Brendanofawesome/SimpleFOC-DualESC/KiCad/simpleFOC Dual Motor Controller.kicad_pcb

## KiCad design KiCad/simpleFOC Dual Motor Controller.kicad_pcb (2026-11-06)

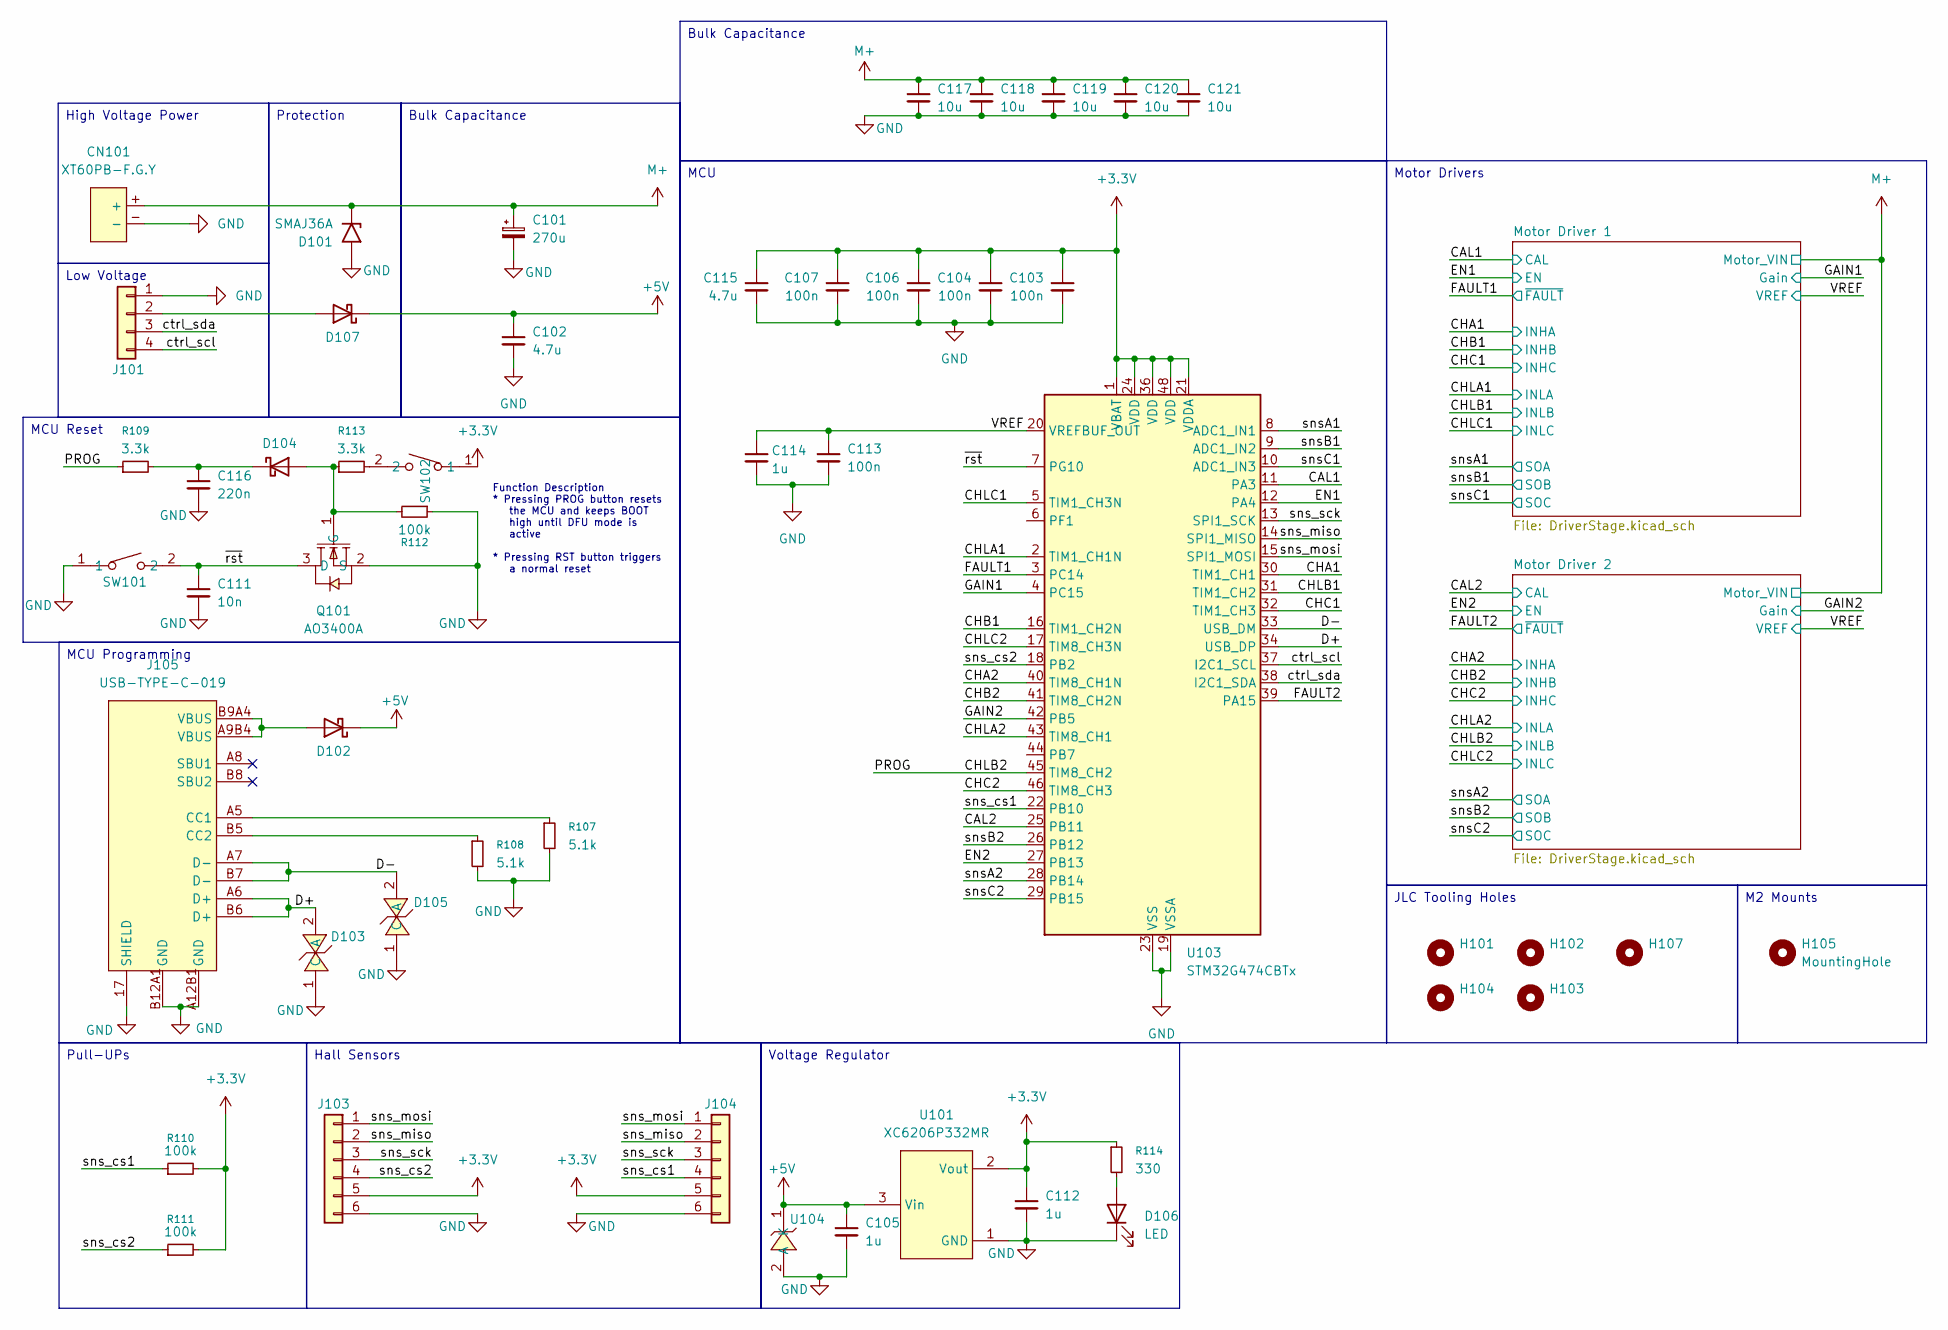
[picture p1: schematic simpleFOC Dual Motor Controller.kicad_sch]

Parts:
C101: 270u; CAP-TH_BD8.0-P3.50-D0.6-FD; LCSC C55079818
C102, C115: 4.7u; C_0402_1005Metric; LCSC C23733
C103, C104, C106, C107, C113: 100n; C_0402_1005Metric; LCSC C307331
C105, C112, C114: 1u; C_0402_1005Metric; LCSC C52923
C111: 10n; C_0402_1005Metric; LCSC C15195
C116: 220n; C_0402_1005Metric; LCSC C16772
C117, C118, C119, C120, C121: 10u; C_1206_3216Metric; LCSC C13585
CN101: XT60PB-F.G.Y; CONN-TH_XT60PB-F.G.Y; MPN XT60PB-F.G.Y; LCSC Part C19268038
D101: SMAJ36A; D_SMA; LCSC C19077550
D102, D104, D107: 1N5819WS; D_SOD-323; LCSC C191023
D103, D105: H5VL10B; SOD-882_L1.0-W0.6-BI; MPN H5VL10B; LCSC Part C7420372
D106: LED; LED_0603_1608Metric; LCSC C2290
H101, H102, H103, H104, H107: MountingHole; JLC_Tooling_Hole
H105: MountingHole; MountingHole_2.2mm_M2
J101: Conn_01x04; JST_PH_B4B-PH-K_1x04_P2.00mm_Vertical; LCSC C131334
J103, J104: Conn_01x06; JST_PH_B6B-PH-K_1x06_P2.00mm_Vertical; LCSC C131342
J105: USB-TYPE-C-019; TYPE-C-SMD_HX-TYPE-C-16PIN; MPN USB-TYPE-C-019; LCSC Part C2927039
Q101: AO3400A; SOT-23-3_L2.9-W1.3-P1.90-LS2.4-BR; MPN AO3400A; LCSC Part C20917
R107, R108: 5.1k; R_0402_1005Metric; LCSC C25905
R109, R113: 3.3k; R_0402_1005Metric; LCSC C25890
R110, R111, R112: 100k; R_0402_1005Metric; LCSC C25741
R114: 330; R_0402_1005Metric; LCSC C25104
SW101, SW102: TS-1088-AR02016; SW-SMD_L3.9-W3.0-P4.45; MPN TS-1088-AR02016; LCSC Part C720477
U101: XC6206P332MR; SOT-23-3_L2.9-W1.6-P1.90-LS2.8-BR; MPN XC6206P332MR-G; LCSC Part C5446
U103: STM32G474CBTx; LQFP-48_7x7mm_P0.5mm; LCSC C730123
U104: H5VND5UB; SOD-523F_L1.7-W0.9-LS1.7-RD; MPN H5VND5UB; LCSC Part C20615819

Connections:
+3.3V: C103.1, C104.1, C106.1, C107.1, C112.1, C115.1, J103.5, J104.5, R110.2, R111.2, R114.1, SW102.1, U101.2 (Vout), U103.1 (VBAT), U103.21 (VDDA), U103.24 (VDD), U103.36 (VDD), U103.48 (VDD); also elsewhere on the board
+5V: C102.1, C105.1, D102.1 (K), D107.1 (K), U101.3 (Vin), U104.1 (K)
/CAL1: U103.11 (PA3); also elsewhere on the board
/CAL2: U103.25 (PB11); also elsewhere on the board
/CHA1: U103.30 (TIM1_CH1); also elsewhere on the board
/CHA2: U103.40 (TIM8_CH1N); also elsewhere on the board
/CHB1: U103.16 (TIM1_CH2N); also elsewhere on the board
/CHB2: U103.41 (TIM8_CH2N); also elsewhere on the board
/CHC1: U103.32 (TIM1_CH3); also elsewhere on the board
/CHC2: U103.46 (TIM8_CH3); also elsewhere on the board
/CHLA1: U103.2 (TIM1_CH1N); also elsewhere on the board
/CHLA2: U103.43 (TIM8_CH1); also elsewhere on the board
/CHLB1: U103.31 (TIM1_CH2); also elsewhere on the board
/CHLB2: R109.1, U103.45 (TIM8_CH2); also elsewhere on the board
/CHLC1: U103.5 (TIM1_CH3N); also elsewhere on the board
/CHLC2: U103.17 (TIM8_CH3N); also elsewhere on the board
/D+: D103.2 (A), J105.A6 (D+), J105.B6 (D+), U103.34 (USB_DP)
/D-: D105.2 (A), J105.A7 (D-), J105.B7 (D-), U103.33 (USB_DM)
/EN1: U103.12 (PA4); also elsewhere on the board
/EN2: U103.27 (PB13); also elsewhere on the board
/FAULT1: U103.3 (PC14); also elsewhere on the board
/FAULT2: U103.39 (PA15); also elsewhere on the board
/GAIN1: U103.4 (PC15); also elsewhere on the board
/GAIN2: U103.42 (PB5); also elsewhere on the board
/VREF: C113.1, C114.1, U103.20 (VREFBUF_OUT); also elsewhere on the board
/ctrl_scl: J101.4, U103.37 (I2C1_SCL)
/ctrl_sda: J101.3, U103.38 (I2C1_SDA)
/snsA1: U103.8 (ADC1_IN1); also elsewhere on the board
/snsA2: U103.28 (PB14); also elsewhere on the board
/snsB1: U103.9 (ADC1_IN2); also elsewhere on the board
/snsB2: U103.26 (PB12); also elsewhere on the board
/snsC1: U103.10 (ADC1_IN3); also elsewhere on the board
/snsC2: U103.29 (PB15); also elsewhere on the board
/sns_cs1: J104.4, R110.1, U103.22 (PB10)
/sns_cs2: J103.4, R111.1, U103.18 (PB2)
/sns_miso: J103.2, J104.2, U103.14 (SPI1_MISO)
/sns_mosi: J103.1, J104.1, U103.15 (SPI1_MOSI)
/sns_sck: J103.3, J104.3, U103.13 (SPI1_SCK)
/~rst: C111.1, Q101.3 (D), SW101.2, U103.7 (PG10)
GND: C101.2, C102.2, C103.2, C104.2, C105.2, C106.2, C107.2, C111.2, C112.2, C113.2, C114.2, C115.2, C116.2, C117.2, C118.2, C119.2, C120.2, C121.2, CN101.-, D101.2 (A2), D103.1 (C), D105.1 (C), D106.1 (K), J101.1, J103.6, J104.6, J105.17 (SHIELD), J105.A12B1 (GND), J105.B12A1 (GND), Q101.2 (S), R107.2, R108.2, R112.1, SW101.1, U101.1 (GND), U103.19 (VSSA), U103.23 (VSS), U103.35 (VSS), U103.47 (VSS), U104.2 (A); also elsewhere on the board
M+: C101.1, C117.1, C118.1, C119.1, C120.1, C121.1, CN101.+, D101.1 (A1); also elsewhere on the board
unnamed: D102.2 (A), J105.A9B4 (VBUS), J105.B9A4 (VBUS)
unnamed: D104.2 (A), Q101.1 (G), R112.2, R113.1
unnamed: C116.1, D104.1 (K), R109.2
unnamed: D106.2 (A), R114.2
unnamed: D107.2 (A), J101.2
unnamed: J105.A5 (CC1), R107.1
unnamed: J105.B5 (CC2), R108.1
unnamed: R113.2, SW102.2

Notes on the sheet:
Function Description * Pressing PROG button resets the MCU and keeps BOOT high until DFU mode is active * Pressing RST button triggers a normal reset
MCU
MCU Reset
Bulk Capacitance
Pull-UPs
JLC Tooling Holes
High Voltage Power
Hall Sensors
Protection
Motor Drivers
Low Voltage
Voltage Regulator
M2 Mounts
MCU Programming

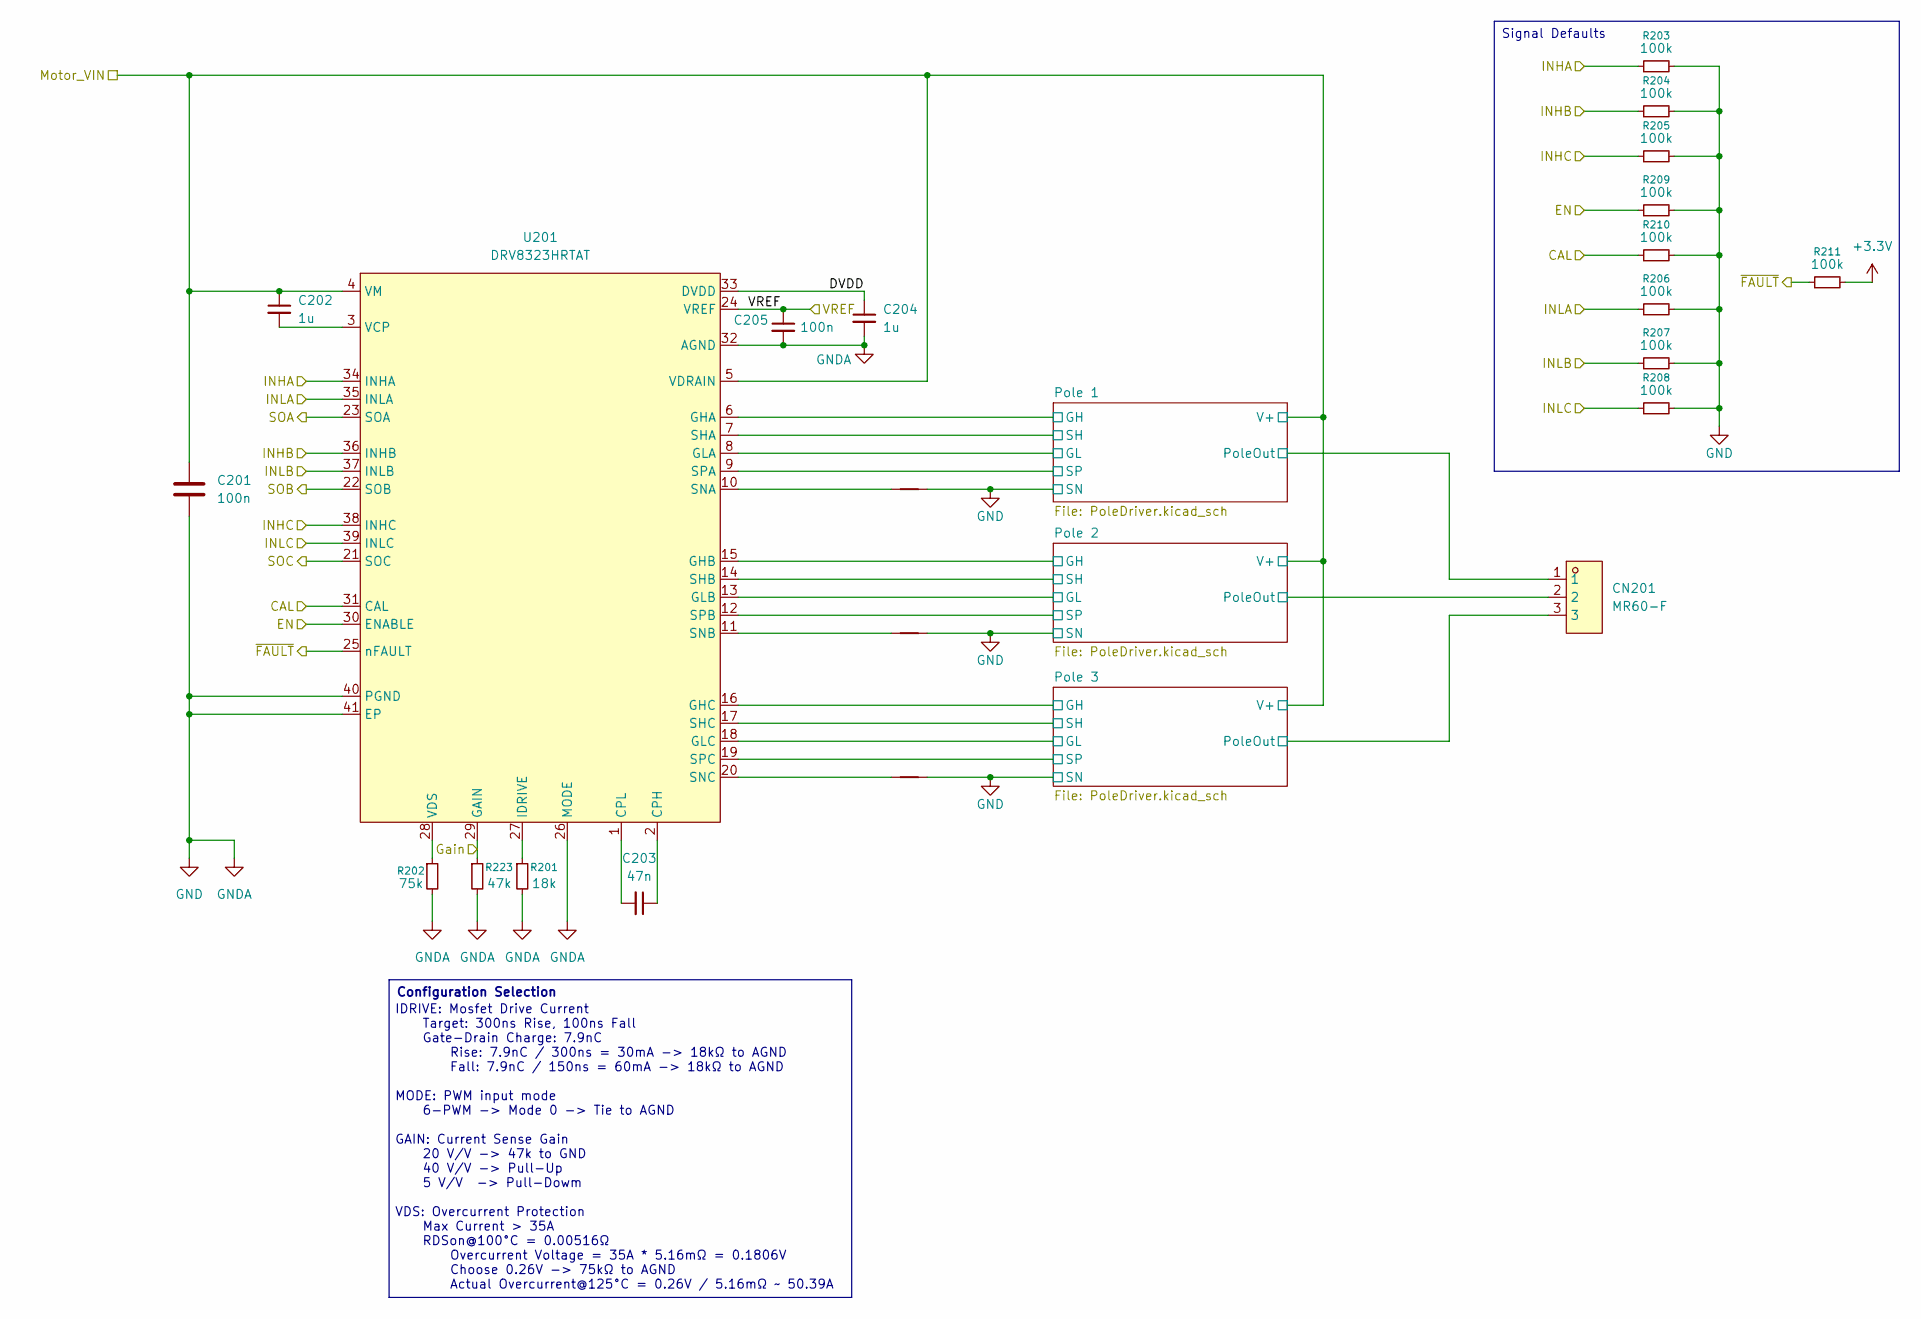
[picture p2: schematic DriverStage.kicad_sch]

Parts:
C201, C205: 100n; C_0402_1005Metric; LCSC C307331
C202: 1u; C_0603_1608Metric; LCSC C15849
C203: 47n; C_0603_1608Metric; LCSC C1622
C204: 1u; C_0402_1005Metric; LCSC C52923
CN201: MR60-F; CONN-TH_3P-P5.50_MR60-F; MPN MR60-F; LCSC Part C9900023305
NT201, NT202, NT203: NetTie_2; NetTie0.127mm
R201: 18k; R_0402_1005Metric; LCSC C25762
R202: 75k; R_0402_1005Metric; LCSC C25798
R203, R204, R205, R206, R207, R208, R209, R210, R211: 100k; R_0402_1005Metric; LCSC C25741
R223: 47k; R_0402_1005Metric; LCSC C25792
U201: DRV8323HRTAT; WQFN-40_L6.0-W6.0-P0.50-TL-EP4.2; MPN DRV8323HRTAT; LCSC Part C2150673

Connections:
+3.3V: R211.2; also elsewhere on the board
/CAL1: R210.1, U201.31 (CAL); also elsewhere on the board
/CHA1: R203.1, U201.34 (INHA); also elsewhere on the board
/CHB1: R204.1, U201.36 (INHB); also elsewhere on the board
/CHC1: R205.1, U201.38 (INHC); also elsewhere on the board
/CHLA1: R206.1, U201.35 (INLA); also elsewhere on the board
/CHLB1: R207.1, U201.37 (INLB); also elsewhere on the board
/CHLC1: R208.1, U201.39 (INLC); also elsewhere on the board
/EN1: R209.1, U201.30 (ENABLE); also elsewhere on the board
/FAULT1: R211.1, U201.25 (nFAULT); also elsewhere on the board
/GAIN1: R223.1, U201.29 (GAIN); also elsewhere on the board
/Motor Driver 1/DVDD: C204.1, U201.33 (DVDD)
/Motor Driver 1/Pole 1/GH: U201.6 (GHA); also elsewhere on the board
/Motor Driver 1/Pole 1/GL: U201.8 (GLA); also elsewhere on the board
/Motor Driver 1/Pole 1/PoleOut: CN201.1, U201.7 (SHA); also elsewhere on the board
/Motor Driver 1/Pole 1/SP: U201.9 (SPA); also elsewhere on the board
/Motor Driver 1/Pole 2/GH: U201.15 (GHB); also elsewhere on the board
/Motor Driver 1/Pole 2/GL: U201.13 (GLB); also elsewhere on the board
/Motor Driver 1/Pole 2/PoleOut: CN201.2, U201.14 (SHB); also elsewhere on the board
/Motor Driver 1/Pole 2/SP: U201.12 (SPB); also elsewhere on the board
/Motor Driver 1/Pole 3/GH: U201.16 (GHC); also elsewhere on the board
/Motor Driver 1/Pole 3/GL: U201.18 (GLC); also elsewhere on the board
/Motor Driver 1/Pole 3/PoleOut: CN201.3, U201.17 (SHC); also elsewhere on the board
/Motor Driver 1/Pole 3/SP: U201.19 (SPC); also elsewhere on the board
/VREF: C205.1, U201.24 (VREF); also elsewhere on the board
/snsA1: U201.23 (SOA); also elsewhere on the board
/snsB1: U201.22 (SOB); also elsewhere on the board
/snsC1: U201.21 (SOC); also elsewhere on the board
GND: C201.2, C204.2, C205.2, NT201.2, NT202.2, NT203.2, R201.2, R202.2, R203.2, R204.2, R205.2, R206.2, R207.2, R208.2, R209.2, R210.2, R223.2, U201.26 (MODE), U201.32 (AGND), U201.40 (PGND), U201.41 (EP); also elsewhere on the board
M+: C201.1, C202.1, U201.4 (VM), U201.5 (VDRAIN); also elsewhere on the board
unnamed: C203.1, U201.2 (CPH)
unnamed: C203.2, U201.1 (CPL)
unnamed: R201.1, U201.27 (IDRIVE)
unnamed: NT201.1, U201.10 (SNA)
unnamed: NT202.1, U201.11 (SNB)
unnamed: NT203.1, U201.20 (SNC)
unnamed: C202.2, U201.3 (VCP)
unnamed: R202.1, U201.28 (VDS)

Parts of its further copies:
C206, C209: 100n; C_0402_1005Metric; LCSC C307331
C207: 1u; C_0603_1608Metric; LCSC C15849
C208: 47n; C_0603_1608Metric; LCSC C1622
C210: 1u; C_0402_1005Metric; LCSC C52923
CN202: MR60-F; CONN-TH_3P-P5.50_MR60-F; MPN MR60-F; LCSC Part C9900023305
NT204, NT205, NT206: NetTie_2; NetTie0.127mm
R212: 75k; R_0402_1005Metric; LCSC C25798
R213: 18k; R_0402_1005Metric; LCSC C25762
R214, R215, R216, R220, R221, R222, R602, R603, R604: 100k; R_0402_1005Metric; LCSC C25741
R601: 47k; R_0402_1005Metric; LCSC C25792
U202: DRV8323HRTAT; WQFN-40_L6.0-W6.0-P0.50-TL-EP4.2; MPN DRV8323HRTAT; LCSC Part C2150673

Connections of its further copies:
+3.3V: R222.2; also elsewhere on the board
/CAL2: R221.1, U202.31 (CAL); also elsewhere on the board
/CHA2: R214.1, U202.34 (INHA); also elsewhere on the board
/CHB2: R215.1, U202.36 (INHB); also elsewhere on the board
/CHC2: R216.1, U202.38 (INHC); also elsewhere on the board
/CHLA2: R602.1, U202.35 (INLA); also elsewhere on the board
/CHLB2: R603.1, U202.37 (INLB); also elsewhere on the board
/CHLC2: R604.1, U202.39 (INLC); also elsewhere on the board
/EN2: R220.1, U202.30 (ENABLE); also elsewhere on the board
/FAULT2: R222.1, U202.25 (nFAULT); also elsewhere on the board
/GAIN2: R601.1, U202.29 (GAIN); also elsewhere on the board
/Motor Driver 2/DVDD: C210.1, U202.33 (DVDD)
/Motor Driver 2/Pole 1/GH: U202.6 (GHA); also elsewhere on the board
/Motor Driver 2/Pole 1/GL: U202.8 (GLA); also elsewhere on the board
/Motor Driver 2/Pole 1/PoleOut: CN202.1, U202.7 (SHA); also elsewhere on the board
/Motor Driver 2/Pole 1/SP: U202.9 (SPA); also elsewhere on the board
/Motor Driver 2/Pole 2/GH: U202.15 (GHB); also elsewhere on the board
/Motor Driver 2/Pole 2/GL: U202.13 (GLB); also elsewhere on the board
/Motor Driver 2/Pole 2/PoleOut: CN202.2, U202.14 (SHB); also elsewhere on the board
/Motor Driver 2/Pole 2/SP: U202.12 (SPB); also elsewhere on the board
/Motor Driver 2/Pole 3/GH: U202.16 (GHC); also elsewhere on the board
/Motor Driver 2/Pole 3/GL: U202.18 (GLC); also elsewhere on the board
/Motor Driver 2/Pole 3/PoleOut: CN202.3, U202.17 (SHC); also elsewhere on the board
/Motor Driver 2/Pole 3/SP: U202.19 (SPC); also elsewhere on the board
/VREF: C209.1, U202.24 (VREF); also elsewhere on the board
/snsA2: U202.23 (SOA); also elsewhere on the board
/snsB2: U202.22 (SOB); also elsewhere on the board
/snsC2: U202.21 (SOC); also elsewhere on the board
GND: C206.2, C209.2, C210.2, NT204.2, NT205.2, NT206.2, R212.2, R213.2, R214.2, R215.2, R216.2, R220.2, R221.2, R601.2, R602.2, R603.2, R604.2, U202.26 (MODE), U202.32 (AGND), U202.40 (PGND), U202.41 (EP); also elsewhere on the board
M+: C206.1, C207.1, U202.4 (VM), U202.5 (VDRAIN); also elsewhere on the board
unnamed: C208.1, U202.2 (CPH)
unnamed: C208.2, U202.1 (CPL)
unnamed: R213.1, U202.27 (IDRIVE)
unnamed: NT204.1, U202.10 (SNA)
unnamed: NT205.1, U202.11 (SNB)
unnamed: NT206.1, U202.20 (SNC)
unnamed: C207.2, U202.3 (VCP)
unnamed: R212.1, U202.28 (VDS)

Notes on the sheet:
IDRIVE: Mosfet Drive Current Target: 300ns Rise, 100ns Fall Gate-Drain Charge: 7.9nC Rise: 7.9nC / 300ns = 30mA -> 18kΩ to AGND Fall: 7.9nC / 150ns = 60mA -> 18kΩ to AGND MODE: PWM input mode 6-PWM -> Mode 0 -> Tie to AGND GAIN: Current Sense Gain 20 V/V -> 47k to GND 40 V/V -> Pull-Up 5 V/V -> Pul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
Signal Defaults
Configuration Selection

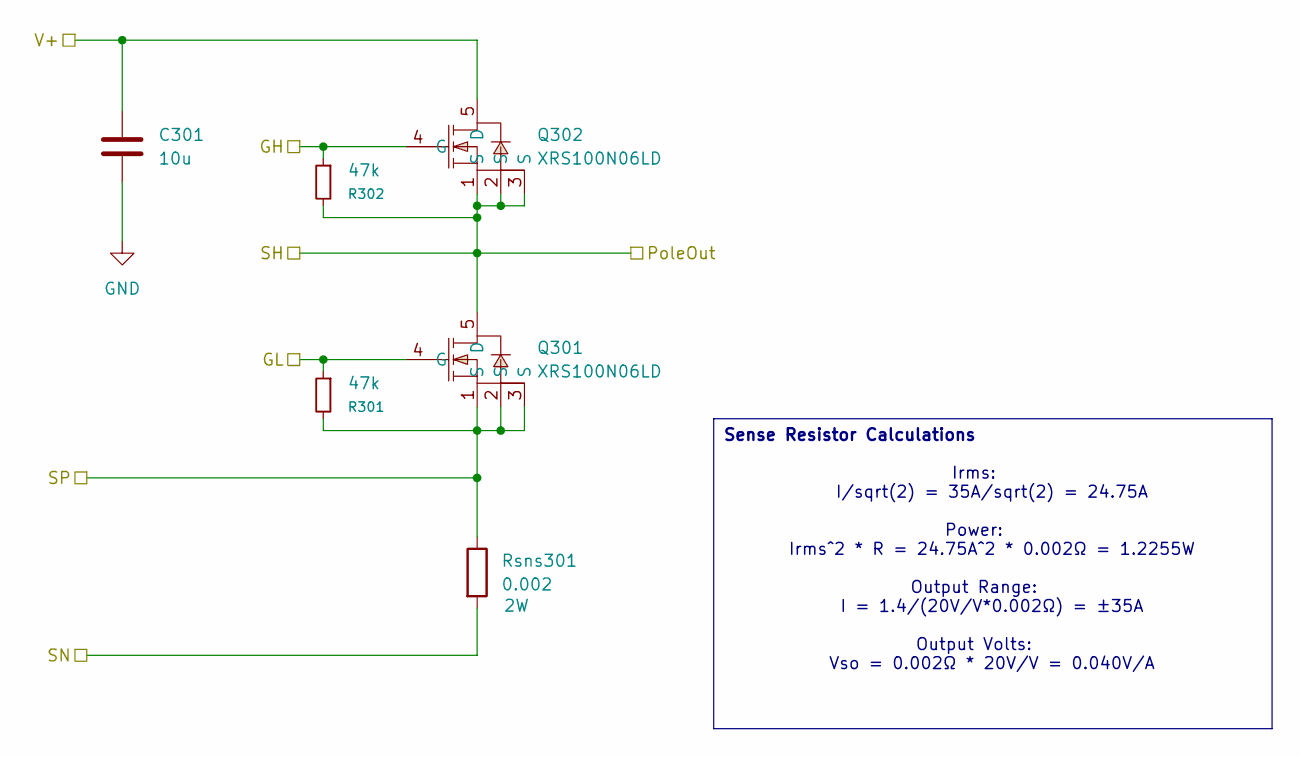
[picture p3: schematic PoleDriver.kicad_sch, Motor Pole Half-Bridge]

Parts:
C301: 10u; C_1206_3216Metric; LCSC C13585
Q301, Q302: XRS100N06LD; DFN-8_L3.0-W3.0-P0.65-BL-4; MPN XRS100N06LD; LCSC Part C42457038
R301, R302: 47k; R_0402_1005Metric; LCSC C25792
Rsns301: 0.002; R_2512_6332Metric; LCSC C7467245

Connections:
/Motor Driver 1/Pole 1/GH: Q302.4 (G), R302.1; also elsewhere on the board
/Motor Driver 1/Pole 1/GL: Q301.4 (G), R301.1; also elsewhere on the board
/Motor Driver 1/Pole 1/PoleOut: Q301.5 (D), Q302.1 (S), Q302.2 (S), Q302.3 (S), R302.2; also elsewhere on the board
/Motor Driver 1/Pole 1/SP: Q301.1 (S), Q301.2 (S), Q301.3 (S), R301.2, Rsns301.1; also elsewhere on the board
GND: C301.2, Rsns301.2; also elsewhere on the board
M+: C301.1, Q302.5 (D); also elsewhere on the board

Parts of its further copies:
C108, C109, C110, C401, C501: 10u; C_1206_3216Metric; LCSC C13585
Q401, Q402, Q501, Q502, Q701, Q702, Q801, Q802, Q901, Q902: XRS100N06LD; DFN-8_L3.0-W3.0-P0.65-BL-4; MPN XRS100N06LD; LCSC Part C42457038
R101, R102, R103, R104, R105, R106, R401, R402, R501, R502: 47k; R_0402_1005Metric; LCSC C25792
Rsns101, Rsns102, Rsns103, Rsns401, Rsns501: 0.002; R_2512_6332Metric; LCSC C7467245

Connections of its further copies:
/Motor Driver 1/Pole 2/GH: Q402.4 (G), R402.1; also elsewhere on the board
/Motor Driver 1/Pole 2/GL: Q401.4 (G), R401.1; also elsewhere on the board
/Motor Driver 1/Pole 2/PoleOut: Q401.5 (D), Q402.1 (S), Q402.2 (S), Q402.3 (S), R402.2; also elsewhere on the board
/Motor Driver 1/Pole 2/SP: Q401.1 (S), Q401.2 (S), Q401.3 (S), R401.2, Rsns401.1; also elsewhere on the board
/Motor Driver 1/Pole 3/GH: Q502.4 (G), R502.1; also elsewhere on the board
/Motor Driver 1/Pole 3/GL: Q501.4 (G), R501.1; also elsewhere on the board
/Motor Driver 1/Pole 3/PoleOut: Q501.5 (D), Q502.1 (S), Q502.2 (S), Q502.3 (S), R502.2; also elsewhere on the board
/Motor Driver 1/Pole 3/SP: Q501.1 (S), Q501.2 (S), Q501.3 (S), R501.2, Rsns501.1; also elsewhere on the board
/Motor Driver 2/Pole 1/GH: Q701.4 (G), R101.1; also elsewhere on the board
/Motor Driver 2/Pole 1/GL: Q702.4 (G), R104.1; also elsewhere on the board
/Motor Driver 2/Pole 1/PoleOut: Q701.1 (S), Q701.2 (S), Q701.3 (S), Q702.5 (D), R101.2; also elsewhere on the board
/Motor Driver 2/Pole 1/SP: Q702.1 (S), Q702.2 (S), Q702.3 (S), R104.2, Rsns101.1; also elsewhere on the board
/Motor Driver 2/Pole 2/GH: Q901.4 (G), R102.1; also elsewhere on the board
/Motor Driver 2/Pole 2/GL: Q902.4 (G), R105.1; also elsewhere on the board
/Motor Driver 2/Pole 2/PoleOut: Q901.1 (S), Q901.2 (S), Q901.3 (S), Q902.5 (D), R102.2; also elsewhere on the board
/Motor Driver 2/Pole 2/SP: Q902.1 (S), Q902.2 (S), Q902.3 (S), R105.2, Rsns102.1; also elsewhere on the board
/Motor Driver 2/Pole 3/GH: Q801.4 (G), R103.1; also elsewhere on the board
/Motor Driver 2/Pole 3/GL: Q802.4 (G), R106.1; also elsewhere on the board
/Motor Driver 2/Pole 3/PoleOut: Q801.1 (S), Q801.2 (S), Q801.3 (S), Q802.5 (D), R103.2; also elsewhere on the board
/Motor Driver 2/Pole 3/SP: Q802.1 (S), Q802.2 (S), Q802.3 (S), R106.2, Rsns103.1; also elsewhere on the board
GND: C108.2, C109.2, C110.2, C401.2, C501.2, Rsns101.2, Rsns102.2, Rsns103.2, Rsns401.2, Rsns501.2; also elsewhere on the board
M+: C108.1, C109.1, C110.1, C401.1, C501.1, Q402.5 (D), Q502.5 (D), Q701.5 (D), Q801.5 (D), Q901.5 (D); also elsewhere on the board

Notes on the sheet:
Irms: I/sqrt(2) = 35A/sqrt(2) = 24.75A Power: Irms^2 * R = 24.75A^2 * 0.002Ω = 1.2255W Output Range: I = 1.4/(20V/V*0.002Ω) = ±35A Output Volts: Vso = 0.002Ω * 20V/V = 0.040V/A
Sense Resistor Calculations

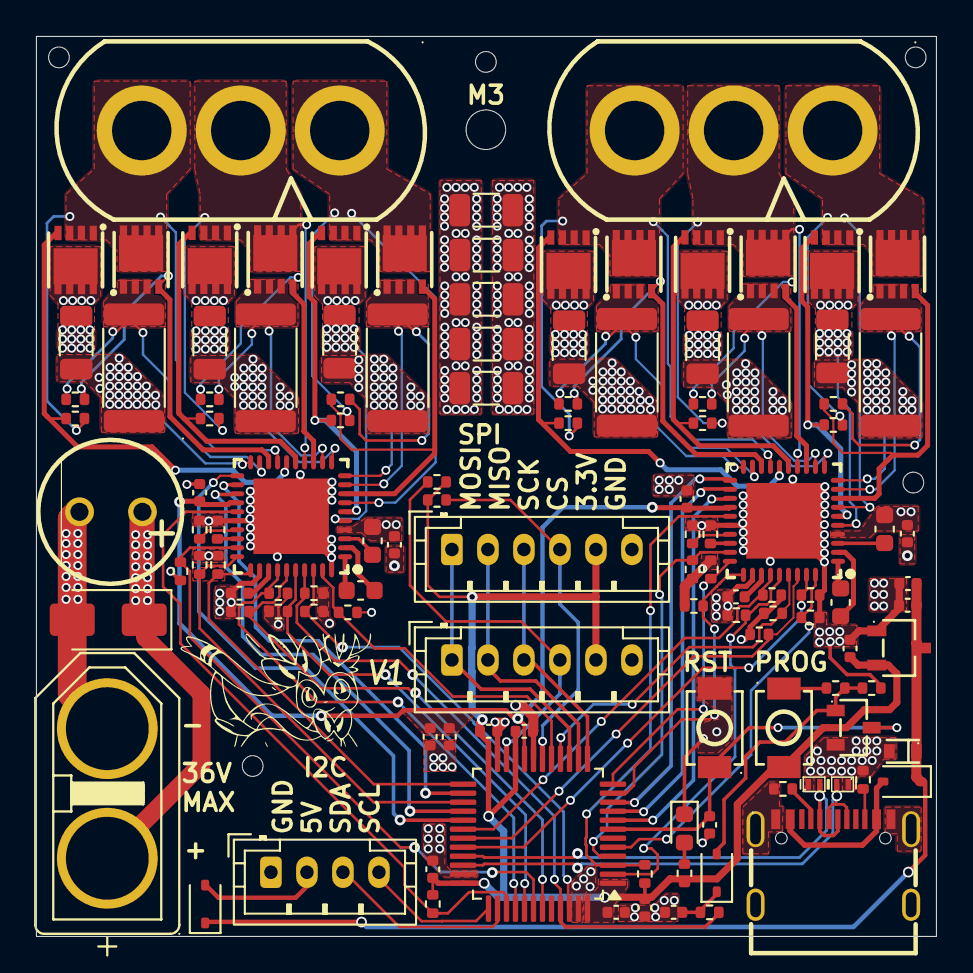
[picture p4: board simpleFOC Dual Motor Controller.kicad_pcb from above]

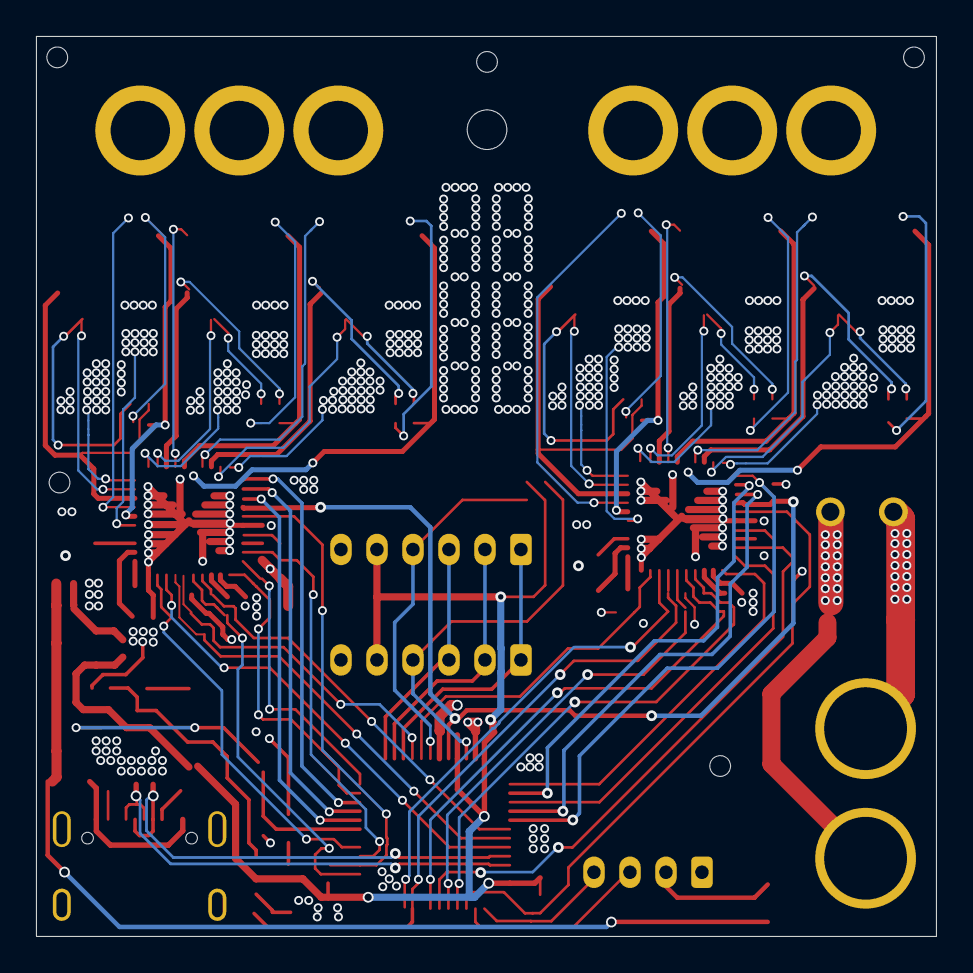
[picture p5: board simpleFOC Dual Motor Controller.kicad_pcb from below]

Board: 4 copper layers, 50.0 x 50.0 mm, 130 parts (6 on the bottom side), 91 nets.
