Brendanofawesome/SimpleFOC-DualESC/(commit log)

2026-05-08 Add simpleFOC Dual Motor Controller KiCad files
    Add a complete KiCad project for the simpleFOC Dual Motor Controller: schematics (DriverStage, PoleDriver, main), PCB, project/prl/pro backup archives, symbol and footprint libraries (including easyeda2kicad parts), 3D models, fp-lib-table and sym-lib-table, and specifications.md. Includes DRV8323HRTAT motor driver symbol, power symbols, capacitors, and other passive components required for the driver stage.
    [DriverStage.kicad_sch, PoleDriver.kicad_sch, simpleFOC Dual Motor Controller.kicad_pcb, simpleFOC Dual Motor Controller.kicad_sch]
2026-05-09 High current drive routing
    Add TDSON-8 3D models and footprint (.step, .wrl, .kicad_mod) and update easyeda2kicad library; modify KiCad schematic sheets (DriverStage.kicad_sch, PoleDriver.kicad_sch, simpleFOC Dual Motor Controller.kicad_sch) to reposition symbols/wires, add connector symbol instances, and refresh UUIDs and component references (e.g. C2/C3/U2 -> C202/C201/U201). Also update PCB and project files to reflect schematic changes so footprints and global labels stay in sync.
    [DriverStage.kicad_sch, PoleDriver.kicad_sch, simpleFOC Dual Motor Controller.kicad_pcb, simpleFOC Dual Motor Controller.kicad_sch]
2026-05-09 added board design rules
    [PoleDriver.kicad_sch, simpleFOC Dual Motor Controller.kicad_pcb]
2026-05-09 Finished wiring motor drive circuitry
    [DriverStage.kicad_sch, PoleDriver.kicad_sch, simpleFOC Dual Motor Controller.kicad_pcb, simpleFOC Dual Motor Controller.kicad_sch]
2026-05-10 started adding supporting components
    [DriverStage.kicad_sch, simpleFOC Dual Motor Controller.kicad_pcb, simpleFOC Dual Motor Controller.kicad_sch]
2026-05-11 considering using this other smaller mosfet
2026-05-11 rewired the board with smaller mosfets
    [DriverStage.kicad_sch, PoleDriver.kicad_sch, simpleFOC Dual Motor Controller.kicad_pcb, simpleFOC Dual Motor Controller.kicad_sch]
2026-05-11 start adding control pins
    [DriverStage.kicad_sch, PoleDriver.kicad_sch, simpleFOC Dual Motor Controller.kicad_pcb, simpleFOC Dual Motor Controller.kicad_sch]
2026-05-12 connected all control pins
    [simpleFOC Dual Motor Controller.kicad_sch]
2026-05-12 not sure why the schematic and pcb aren't syncing :(
    [simpleFOC Dual Motor Controller.kicad_pcb, simpleFOC Dual Motor Controller.kicad_sch]
2026-05-12 connected a few more signals
    [simpleFOC Dual Motor Controller.kicad_pcb, simpleFOC Dual Motor Controller.kicad_sch]
2026-05-13 updated configuration for new mosfets
    [DriverStage.kicad_sch, PoleDriver.kicad_sch, simpleFOC Dual Motor Controller.kicad_pcb, simpleFOC Dual Motor Controller.kicad_sch]
2026-05-13 swapped CPU for ESP32
    [simpleFOC Dual Motor Controller.kicad_pcb]
2026-05-14 started laying out
    [DriverStage.kicad_sch, simpleFOC Dual Motor Controller.kicad_pcb, simpleFOC Dual Motor Controller.kicad_sch]
2026-05-17 added hall connectors
    [simpleFOC Dual Motor Controller.kicad_pcb, simpleFOC Dual Motor Controller.kicad_sch]
2026-05-17 started routing
    [simpleFOC Dual Motor Controller.kicad_pcb, simpleFOC Dual Motor Controller.kicad_sch]
2026-05-17 mostly finished routing
    [DriverStage.kicad_sch, simpleFOC Dual Motor Controller.kicad_pcb, simpleFOC Dual Motor Controller.kicad_sch]
2026-05-20 finished iteration 1
    [DriverStage.kicad_sch, PoleDriver.kicad_sch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]
2026-05-20 generated production files
    [simpleFOC Dual Motor Controller-CuBottom.gbr, simpleFOC Dual Motor Controller-CuIn1.gbr, simpleFOC Dual Motor Controller-CuIn2.gbr, simpleFOC Dual Motor Controller-CuTop.gbr, simpleFOC Dual Motor Controller-EdgeCuts.gbr, simpleFOC Dual Motor Controller-MaskBottom.gbr, simpleFOC Dual Motor Controller-MaskTop.gbr, simpleFOC Dual Motor Controller-NPTH.drl]
2026-05-21 added bulk ceramic capacitance
    [simpleFOC Dual Motor Controller.kicad_pcb, simpleFOC Dual Motor Controller.kicad_sch]
2026-06-12 created single motor PCB project
    [simpleFOC Dual Motor Controller-CuBottom.gbr, simpleFOC Dual Motor Controller-CuIn1.gbr, simpleFOC Dual Motor Controller-CuIn2.gbr, simpleFOC Dual Motor Controller-CuTop.gbr, simpleFOC Dual Motor Controller-EdgeCuts.gbr, simpleFOC Dual Motor Controller-MaskBottom.gbr, simpleFOC Dual Motor Controller-MaskTop.gbr, simpleFOC Dual Motor Controller-NPTH.drl]
2026-11-06 Added LCSC part number for bulk capacitor and minor trace movements for tolerance
    [DriverStage.kicad_sch, PoleDriver.kicad_sch, simpleFOC Dual Motor Controller.kicad_pcb, simpleFOC Dual Motor Controller.kicad_sch]
2026-11-09 Revise power input description in README.md
    Updated the README to clarify power input specifications and improve wording.
2026-11-09 Update README with assembly and functionality details
    Added information about economic assembly and clarified board capabilities.
